C0SM1N23/siemens/cpu/README.md

# RISC-V RV32I CPU — 3-stage pipeline with AXI4-Lite

The CPU block of the SoC (CPU + DMA + DP-SRAM), in Verilog. A 3-stage RV32I
pipeline with two AXI4-Lite master ports, a branch predictor with a
return-address stack, precise traps, WFI, and an M-mode CSR file with
performance counters. The block includes the programmable interrupt controller
from the PIC brief ([pic.v](hdl/pic.v)) and a machine timer
([mtimer.v](hdl/mtimer.v)) for scheduling and timeout handling.

Block diagrams and per-module detail: [ARCHITECTURE.md](ARCHITECTURE.md). Test
plan and results: [debug/VERIFICATION.md](debug/VERIFICATION.md).

## Architecture

```
S1 FETCH ──────────── S2 DECODE + EXECUTE ─────────── S3 WRITEBACK
ibus_axi (AR/R)       decode, regfile, ALU, branch,    rd write
+ branch predictor    CSR, load/store on dbus_axi      (S3->S2 forwarding)
  (BTB/BHT, 128,      traps/interrupts resolve here;
   + 8-entry RAS)     WFI sleeps here (ibus goes idle)
```

One clock, async active-low reset. Pipeline registers carry a `valid` bit, so a
flushed or reset stage is a guaranteed no-op. Load-use hazards go through S3→S2
forwarding (no stall); the two AXI ports are independent, one outstanding
transaction each, so a fetch and a load/store overlap.

## Spec requirements vs. design decisions

The brief separates two kinds of item, so does this repo:

- **Spec requirements** (`REQ#`) — the original scope, interpreted using the
  RISC-V and AXI rules where the brief does not define detailed behaviour.
- **Design decisions** (`D#`) — points the brief left "for the intern to
  define". Each a deliberate choice with a rationale.

The tables below index the original requirements and project decisions.
Current interface details and limitations are in [docs/](docs/).

### Requirement mapping

| Tag | Requirement | File(s) |
|-----|---|---|
| REQ1  | 3-stage pipeline: Fetch / Decode+Execute / Writeback | [rv32i_cpu_top.v](hdl/rv32i_cpu_top.v) |
| REQ2  | Two AXI4-Lite master ports: ibus (read-only), dbus (read+write) | [rv32i_cpu_top.v](hdl/rv32i_cpu_top.v) |
| REQ3  | Top interface: 1 sync clock, async active-low reset, PIC lines | [rv32i_cpu_top.v](hdl/rv32i_cpu_top.v) |
| REQ4  | Interrupts sampled under `mstatus.MIE` at instruction boundaries; ack 1-cycle pulse; `cpu_in_trap` entry→MRET | [rv32i_cpu_top.v](hdl/rv32i_cpu_top.v) |
| REQ5  | Pipeline stalls until AXI response valid; data op stalls the whole round-trip | [rv32i_fetch_unit.v](hdl/rv32i_fetch_unit.v), [rv32i_lsu.v](hdl/rv32i_lsu.v) |
| REQ6  | Dedicated centralized hazard/stall/flush unit | [rv32i_hazard_unit.v](hdl/rv32i_hazard_unit.v) |
| REQ7  | RV32I instruction set; FENCE = NOP; ECALL/EBREAK trap-handled | [rv32i_control.v](hdl/rv32i_control.v) (+ reused alu/rv32i_decode/imm_gen) |
| REQ8  | 1-bit saturating branch predictor | [rv32i_branch_predictor.v](hdl/rv32i_branch_predictor.v) |
| REQ9  | The 7 required M-mode CSRs at their addresses; `mip` read-only, PIC-driven | [rv32i_csr_file.v](hdl/rv32i_csr_file.v) |
| REQ10 | Register file: 32×32, x0=0, 1 write / 2 combinational reads, reset 0 | [rv32i_regfile.v](hdl/rv32i_regfile.v) |
| REQ11 | WSTRB byte-lane writes (SB/SH/SW) as AXI / DP-SRAM require | [rv32i_lsu.v](hdl/rv32i_lsu.v) |
| REQ12 | Handle all AXI response codes (OKAY/SLVERR/DECERR) on both ports | [rv32i_fetch_unit.v](hdl/rv32i_fetch_unit.v), [rv32i_lsu.v](hdl/rv32i_lsu.v) |

### Design decisions (intern-defined)

| Tag | Decision | File(s) |
|-----|---|---|
| D1  | `valid`-bit pipeline registers → guaranteed safe bubble (not the NOP encoding) | [rv32i_cpu_top.v](hdl/rv32i_cpu_top.v) |
| D2  | S2 priority: interrupt > sync exception > mispredict, as a sequential check | [rv32i_cpu_top.v](hdl/rv32i_cpu_top.v) |
| D3  | Supported mcause set 0,1,2,3,4,5,6,7,11 + external interrupts on 16 PIC sources (causes 16..31) | [rv32i_exception_unit.v](hdl/rv32i_exception_unit.v), [rv32i_csr_file.v](hdl/rv32i_csr_file.v) |
| D4  | Trap return: exceptions → offending PC, interrupts → resume PC | [rv32i_cpu_top.v](hdl/rv32i_cpu_top.v) |
| D5  | `RESET_PC` + `HART_ID` params → `mhartid` (multi-core; beyond spec) | [rv32i_cpu_top.v](hdl/rv32i_cpu_top.v), [rv32i_csr_file.v](hdl/rv32i_csr_file.v) |
| D6  | ibus master fully independent, ≤1 outstanding, back-to-back fetch (1 instr/cycle) | [rv32i_fetch_unit.v](hdl/rv32i_fetch_unit.v) |
| D7  | Holding register keeps PC correct in a stall; in-flight fetch discarded on redirect | [rv32i_fetch_unit.v](hdl/rv32i_fetch_unit.v) |
| D8  | Fetch bus error → instruction access fault (mcause 1), not "illegal" | [rv32i_fetch_unit.v](hdl/rv32i_fetch_unit.v) |
| D9  | Predictor structure: BHT+BTB, direct-mapped, 128 entries, index PC[8:2], tag + stored target | [rv32i_branch_predictor.v](hdl/rv32i_branch_predictor.v) |
| D10 | Miss predicts not-taken | [rv32i_branch_predictor.v](hdl/rv32i_branch_predictor.v) |
| D11 | Learned at S2 resolution (non-speculative); entries kept across traps | [rv32i_branch_predictor.v](hdl/rv32i_branch_predictor.v) |
| D12 | ≤1 outstanding transaction; address/data latched at start | [rv32i_lsu.v](hdl/rv32i_lsu.v) |
| D13 | Load-use solved by S3→S2 forwarding, zero stall cycles | [rv32i_hazard_unit.v](hdl/rv32i_hazard_unit.v) |
| D14 | Flush beats stall; both priority rules gated by `s2_advance` | [rv32i_hazard_unit.v](hdl/rv32i_hazard_unit.v) |
| D15 | Unimplemented / read-only CSR access → illegal instruction (not DECERR) | [rv32i_csr_file.v](hdl/rv32i_csr_file.v) |
| D16 | Vectored mtvec: interrupts → BASE+4·cause, exceptions → BASE | [rv32i_csr_file.v](hdl/rv32i_csr_file.v) |
| D17 | Misalignment checked pre-access → no AXI transaction issued | [rv32i_exception_unit.v](hdl/rv32i_exception_unit.v) |
| D18 | Bus error → access fault (load 5 / store 7) | [rv32i_exception_unit.v](hdl/rv32i_exception_unit.v) |
| D19 | PIC implements the "Advanced Scheduling" brief: 16 hardware + 16 software sources → one prioritised `cpu_irq`/`cpu_irq_vec`, registered off the source timing path (D-LAT) | [pic.v](hdl/pic.v) |
| D20 | Custom priority grouping: 4 bands (per-band urgency in `BAND_CONFIG`) + per-source intra-band priority + lowest-index tie-break; deadline-aware escalation bumps a starved source's effective band (D-BAND / D-DDL) | [pic.v](hdl/pic.v) |
| D21 | Preemption with a nesting stack (depth ≤ `NEST_MAX`): `cpu_irq_ack` claims/pushes, `cpu_irq_eoi` returns/pops; a source that deasserts before its claim is flagged spurious + logged, never corrupts the stack (D-NEST / D-SPUR) | [pic.v](hdl/pic.v) |
| D22 | Full register map (SRCx_CONFIG/SW_TRIG/STATUS, BAND_CONFIG, NEST_STATUS/MAX, ACTIVE_VEC, SPURIOUS_LOG, ESCALATION_CFG, INT_ENABLE/STATUS); keyed software triggers; unmapped or read-only-write access answers SLVERR (D-SW / D-AXI) | [pic.v](hdl/pic.v) |
| D23 | WFI (Priv. spec 3.3.3): S2 sleeps, S1 parks → zero ibus traffic; wake on any mie-enabled pending irq, `mstatus.MIE` decides trap-vs-fall-through; interrupt wake sets mepc = wfi+4 | [rv32i_control.v](hdl/rv32i_control.v), [rv32i_cpu_top.v](hdl/rv32i_cpu_top.v), [rv32i_hazard_unit.v](hdl/rv32i_hazard_unit.v) |
| D24 | Return-address stack (8 entries, parameterized, 0 = off): calls/returns keyed on the ISA JALR hint regs (x1/x5); BTB entries tagged `is_ret` predict the RAS top; learned at commit like the BTB (never speculative) | [rv32i_branch_predictor.v](hdl/rv32i_branch_predictor.v) |
| D25 | `mhpmcounter3..7`: mispredicts, fetch-starved cycles, dbus stall cycles, traps taken, WFI sleep cycles — the CPU-side numbers that pair with DP-SRAM BANDWIDTH_A/B and DMA throttling. All counters are 64-bit with an upper half at base+0x80 and writable from M-mode (Priv. 3.1.11); the counters not provided are hardwired zero, not unimplemented | [rv32i_csr_file.v](hdl/rv32i_csr_file.v) |
| D26 | Machine timer (unassigned in the briefs): 64-bit mtime/mtimecmp, level irq = compare, born disarmed; handler clears by moving mtimecmp — feeds PIC source 7 | [mtimer.v](hdl/mtimer.v) |
| D27 | mtimer AXI4-Lite slave port, same discipline as the PIC's (D-AXI): 4 R/W word registers, SLVERR elsewhere, WSTRB honored per lane | [mtimer.v](hdl/mtimer.v) |

## AXI4-Lite interface (SoC integration)

Both ports are conformant AXI4-Lite masters — no proprietary extensions — so the
DMA config port and DP-SRAM Port A see a standard master.

- `ibus_axi` — read only (AR/R), instruction fetch.
- `dbus_axi` — read + write (AW/W/B/AR/R), load/store, `WSTRB` per byte lane (REQ11).
- One outstanding transaction per port; the FSMs split per channel, so a later
  move to AXI4-Full (bursts, IDs) stays additive, not a rewrite (D6, D12).
- All three response codes handled (REQ12): OKAY, plus SLVERR/DECERR → precise
  access-fault traps (D8, D18). DP-SRAM only emits OKAY/SLVERR; DECERR comes
  from the interconnect on an unmapped address — the CPU covers both.

## Interrupts (PIC)

The PIC implements the *Programmable Interrupt Controller with Advanced
Scheduling* brief ([pic/](pic/)): 16 hardware sources + 16 software channels
(32 logical sources), custom priority grouping, preemption with nesting,
spurious detection, deadline-aware escalation, and software-triggered
interrupts. Full design in [pic.v](hdl/pic.v) and [ARCHITECTURE.md](ARCHITECTURE.md) §5.

The CPU side: `cpu_irq_i` (single level request), `cpu_irq_vec_i[3:0]` (id of
the offered source), `cpu_irq_ack_o` (1-cycle claim pulse at handler entry),
`cpu_irq_eoi_o` (1-cycle pulse on an interrupt-returning MRET). Every port in
the design carries a direction suffix, `_i` or `_o`; internal wires do not. A source maps
to mcause `16+vec`; the CPU builds a one-hot `mip[16+vec]` from the offer, and
`mie[16+vec]` is the per-source CPU enable. An irq is taken only at an
instruction boundary, only under `mstatus.MIE`, held through a multi-cycle AXI
stall (REQ4; priority D2).

The PIC side (D19–D22): a slot's request is `(level ? irq_src : edge_latch |
sw) & INT_ENABLE`. The resolver builds an effective priority key
`{band_urgency, intra_priority, ~index}` per source and offers the most urgent
one that is strictly above the top of the nesting stack, so a higher source
**preempts** a lower one; `cpu_irq_ack` pushes it (claim), `cpu_irq_eoi` pops it
(return). A source whose deadline elapses before it is serviced has its band
**escalated** (`ESCALATION_CFG`). A source that deasserts before its claim is
flagged **spurious** (`SPURIOUS_LOG`, `INT_STATUS.SPUR`) without corrupting the
stack. Software injects an interrupt with a keyed `SRCx_SW_TRIG` write. Everything
is programmed over an AXI4-Lite slave port (register map in ARCHITECTURE.md §5);
unmapped words and read-only writes answer SLVERR. The PIC's `INT_ENABLE` and the
CPU's `mie` are two independent masks: a source PIC-enabled but `mie`-masked sits
as the PIC's offer forever and starves the rest, so route a source into the PIC
only if some handler will service it.

The timer ([mtimer.v](hdl/mtimer.v), D26/D27) sits on PIC source 7:
64-bit `mtime`/`mtimecmp` behind an AXI4-Lite slave port, level irq while
`mtime >= mtimecmp`, disarmed at reset. With WFI (D23) it gives the SoC an
idle mode: program the DMA, arm the timer as a deadline, execute WFI. The CPU
stops fetching while the DMA works; either the completion interrupt or the
timer wakes it. A timeout handler can abort a stuck DMA channel over
`CHx_CONTROL`.

## Multi-core

Nothing shared between instances: no static state, memories external, identity
only from the `HART_ID`/`RESET_PC` parameters (D5). Two or more cores work
behind a standard AXI interconnect. RV32I has no LR/SC, but each core is
in-order with blocking memory ops (sequentially consistent per hart), so
flag-based sharing through memory is sound — the same property the SoC's
ping-pong buffering relies on. `debug/hdl/rv32i_tb_dual_core.v` shows two cores
sharing one memory through an arbiter.

## Layout

```
hdl/
  rv32i_cpu_top.v            top level: pipeline + AXI + PIC          (REQ1-4; D1,D2,D4,D5)
  rv32i_fetch_unit.v         S1: PC + ibus master + holding/redirect  (REQ5,12; D6-D8)
  rv32i_branch_predictor.v   BTB/BHT                                  (REQ8; D9-D11)
  rv32i_lsu.v                S2: dbus master, alignment + WSTRB       (REQ5,11,12; D12)
  rv32i_hazard_unit.v        centralized stall/flush/forwarding       (REQ6; D13,D14)
  rv32i_control.v            decoder (RV32I, FENCE=NOP, SYSTEM)       (REQ7)
  rv32i_csr_file.v           M-mode CSRs + trap/MRET sequencing       (REQ9; D3,D5,D15,D16)
  rv32i_exception_unit.v     sync exception detect                    (D3,D17,D18)
  pic.v                advanced-scheduling interrupt controller (D19-D22)
  mtimer.v             machine timer, AXI4-Lite + irq to PIC 7  (D26,D27)
  axi_lite_slave.v     reusable AXI4-Lite register interface (shared by pic/mtimer)
  rv32i_regfile.v            32x32 register file                      (REQ10)
  rv32i_branch_unit.v        real branch/jump direction + target
  rv32i_decode.v  rv32i_imm_gen.v  rv32i_alu.v  rv32i_alu_top.v  rv32i_writeback_mux.v   (reused, combinational)
debug/
  VERIFICATION.md      test plan: what is checked, why, and known gaps
debug/formal/
  pic_formal.sv  pic.sby  SymbiYosys harness: stack, limit, key and offer invariants
  run_formal.sh        proofs, then the harness against injected defects
debug/sva/
  axi_lite_sva.sv      AXI4-Lite contract as SVA (per port: ibus/dbus/PIC)
  rv32i_cpu_core_sva.sv      pipeline invariants as SVA (REQ4,10,11; D2,D3,D12)
  pic_sva.sv           PIC invariants as SVA (D-LAT/D-BAND/D-NEST)
  rv32i_cpu_func_cov.sv      functional coverage bins + end-of-run [FCOV] table
  rv32i_bind_sva.sv          attaches everything with bind - zero RTL edits
debug/hdl/
  rv32i_tb_cpu_axi.v         self-checking TB: CPU + real PIC @ 0x3000_0000 + AXI
                       memories + monitors; the TB plays the peripherals
  pic_tb_feature.v             standalone PIC feature bench: bands, nesting, spurious,
                       deadline escalation, software triggers, AXI responses
  rv32i_tb_dual_core.v       2 CPUs + shared memory behind an arbiter (scalability proof)
  axi_lite_monitor.v   passive AXI4-Lite protocol checker (ibus, dbus, PIC port)
  axi_lite_mem_model.v behavioral AXI4-Lite slave (OKAY/DECERR, latency + seeded
                       random READY backpressure)
  axi_lite_arb2.v      2:1 AXI4-Lite arbiter (TB stand-in for the interconnect)
  axi_lite_dec2.v      1-master/2-slave address decoder (TB interconnect for
                       the PIC window)
  ck_rst_tb.v          clock/reset generator (async reset, released at 123 ns)
  pic_tb_reset.v       PIC reset values, X-freedom, asynchronous reset
  pic_tb_ro.v          PIC read-only registers and reserved bits
  pic_tb_status.v      PIC SRCx_STATUS, field by field
  mtimer_tb_regs.v     machine-timer registers, reset and access rules
  rv32i_tb_csr_ro.v          CSR file: read-only, WARL, tied-off, absent
  rv32i_tb_traps.v           one directed test per trap cause, at CPU level
  rv32i_tb_bp.v              branch predictor: tables, RAS boundaries, reset
  rv32i_tb_alu.v             ALU operation decode and operand boundaries
  pic_tb_random.v      constrained-random PIC traffic, traced for pic_model.py
  rv32i_tb_riscv_tests.v     runs one official riscv-test, verdict from tohost
  tb_check.vh          shared self-check task (=== compare, PASS/FAIL per check)
  tb_axil_master.vh    shared AXI4-Lite master driver tasks for the block benches
  axi_lite_macros.vh   bare AXI read/write helper macros shared by the benches
debug/sim/
  program_axi.s        main test program   (py asm.py program_axi.s program_axi.hex)
  program_dual.s       dual-core handshake (py asm.py program_dual.s program_dual.hex)
  asm.py               tiny RV32I assembler (range-checked imms, %hi/%lo, .org)
  rtl.f  tb_cpu.f      shared filelists — one module list for both flows,
                       ordered bottom-up by dependency level (see rtl.f header)
  tb_block.f           filelist for the block-level benches
  compile.do           the single canonical vlog compile both .do scripts use
  rv32i_soc_map.vh           TB address map (PIC / mtimer / dmem bases) in one place
  sim.do               quick single run     regress.do  full 39-run regression
  wave.do              AXI-grouped waveform set for the ModelSim GUI
  run_verilator.sh     SVA + functional coverage run (Verilator, free)
  isa_reference.py     ISA encoder/interpreter: directed and ten random programs
  pic_model.py         cycle-accurate PIC model, replays pic_tb_random traces
  merge_fcov.py        functional coverage merged over runs, with its gate
  check_covers.py      cover properties merged over runs, with its gate
  run_riscv_tests.sh   official rv32ui/rv32mi tests (riscv_tests.ld, riscv_tests_expected.json)
  mutation_check.py    injects RTL defects one at a time; each must fail its bench
  run_verilator.ps1    same, one command from Windows (via WSL)
  verif_gui.py         tkinter front-end that launches the flows and shows
                       PASS/FAIL per job (no ModelSim/Verilator CLI needed)
```

## Simulation

From `cpu/debug/sim`:

```text
python isa_reference.py
python pic_reference.py
python asm.py program_axi.s program_axi.hex
python asm.py program_dual.s program_dual.hex
vsim -c -do "do regress.do; quit -f"
```

Verilator, from the repository root in Bash/WSL:

```text
bash cpu/debug/sim/run_verilator.sh
```

Windows launcher: `cpu/debug/sim/run_verilator.ps1`. GUI:
`python cpu/debug/sim/verif_gui.py`.

The ModelSim regression has 17 benches and 39 runs, timing variants and random
seeds included. Verilator runs all of them with the bound SVA, merges the
functional coverage over the runs and requires every cover property to be
reached. The official riscv-tests, the PIC's formal proofs and the mutation
check complete the evidence. ModelSim compilation reports zero errors/warnings;
CPU RTL lint is clean under the recorded options. RTL files have no
`timescale`; verification supplies simulation time units.

Test inventory, commands and limits: [debug/VERIFICATION.md](debug/VERIFICATION.md).

## Integration contract

The SoC memory and interrupt maps are defined in
[../soc/README.md](../soc/README.md). The sixteen-source claim/EOI interface is
a project decision that resolves differing CPU/PIC brief widths; it is recorded
in [../INTEGRATION.md](../INTEGRATION.md).

The current PIC targets one CPU. The dual-core bench verifies two CPU instances
sharing data memory; it does not implement multicore interrupt routing.
The core's trap-kind stack supports sixteen combined open interrupt/exception
levels. Software must stay within that limit.
