C0SM1N23/siemens/docs/README.md

# docs

Shared project material and the faculty internship report. The RTL and its testbenches
stay in [cpu/](../cpu/), [dma/](../dma/), [sram/](../sram/) and [soc/](../soc/).

The Design and Verification Specifications live with the blocks they describe,
in [cpu/docs/](../cpu/docs/), not here.

| Path | What it is |
|---|---|
| [practica/](practica/) | Internship report for the faculty — LaTeX source and the built PDF. The completed logbook (DOCX) is kept locally. |
| `brief/` | Shared/DMA/SRAM Siemens material, kept locally. CPU/PIC briefs are in `cpu/docs/brief/`. |
| `../cpu/docs/tehnic/`, `../cpu/docs/diagrame/`, `../cpu/docs/note/` | Local engineering notes, drawio drawings and the changelog. |

## practica/

`Raport_practica_Bunea_Cosmin-Andrei.tex` is a single self-contained file: no
`\input`, no separate preamble. The only external file it needs is the
university logo in `assets/`.

**It must be built with LuaLaTeX, not pdfLaTeX.** Romanian `ș` and `ț` carry a
comma below, not a cedilla, and only the OpenType font has real glyphs for them;
under pdfLaTeX with T1 they get composed from a base letter plus an accent and
look wrong.

```
cd docs/practica
lualatex Raport_practica_Bunea_Cosmin-Andrei.tex   # three times, for the ToC
```

42 pages. Covers the internship context and the split of work between the three
interns, the RV32I CPU, the interrupt controller and the machine timer, the SoC
integration, and the verification results.

The faculty report is retained as submitted. Current CPU/SoC technical results
are maintained in the block specifications and verification documents.

## A note on what is committed

`.gitignore` keeps PDFs, Office documents and archives out of the repository,
because `brief/` holds Siemens material marked Restricted. The faculty report
and the authored CPU/PIC specifications, figures and presentations are explicit
exceptions, committed with their sources.
