C0SM1N23/siemens/cpu/docs/figures/pic_essential.pdf

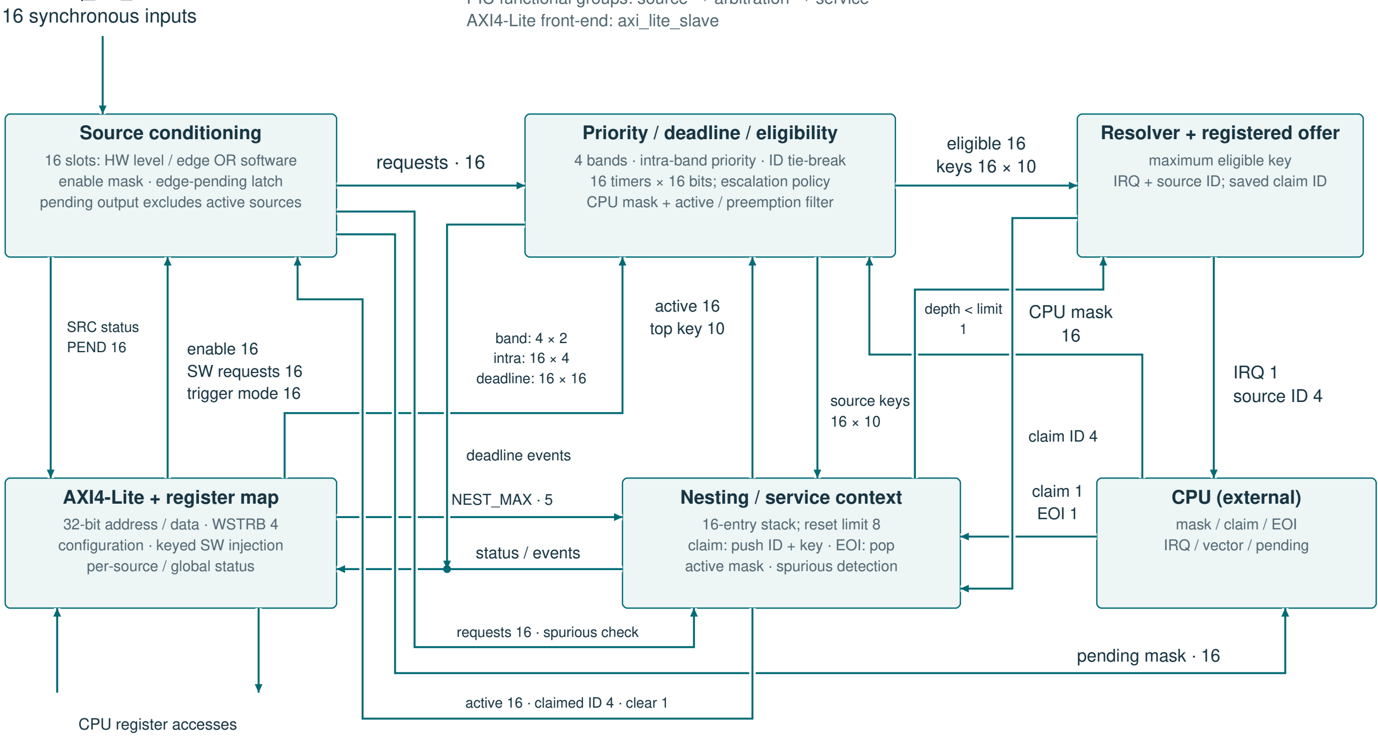
[picture p6: figure]
Source conditioning 16 slots: HW level / edge OR software enable mask · edge-pending latch pending output excludes active sources; Priority / deadline / eligibility; 16 timers × 16 bits; escalation policy CPU mask + active / preemption filter; Resolver + registered offer maximum eligible key IRQ + source ID; saved claim ID; AXI4-Lite + register map 32-bit address / data · WSTRB 4 configuration · keyed SW injection per-source / global status; Nesting / service context 16-entry stack; reset limit 8 claim: push ID + key · EOI: pop active mask · spurious detection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

4 bands · intra-band priority · ID tie-break

## irq_src_i

PIC functional groups: source → arbitration → service

AW / W / AR requests; B / R responses Priority key: urgency 2 + intra-band priority 4 + inverted ID 4.
