C0SM1N23/siemens/cpu/docs/figures/cpu_software.pdf

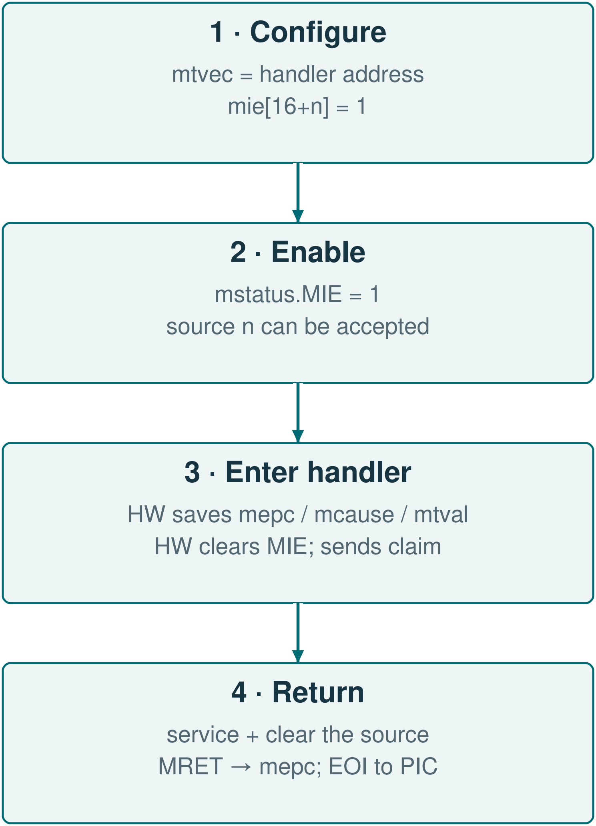
[picture p41: figure]
1 · Configure mtvec = handler address mie[16+n] = 1; 2 · Enable mstatus.MIE = 1 source n can be accepted; 3 · Enter handler HW saves mepc / mcause / mtval HW clears MIE; sends claim; 4 · Return service + clear the source MRET → mepc; EOI to PIC

CPU instructions ↔ hardware state
