C0SM1N23/siemens/cpu/docs/figures/pic_software.pdf

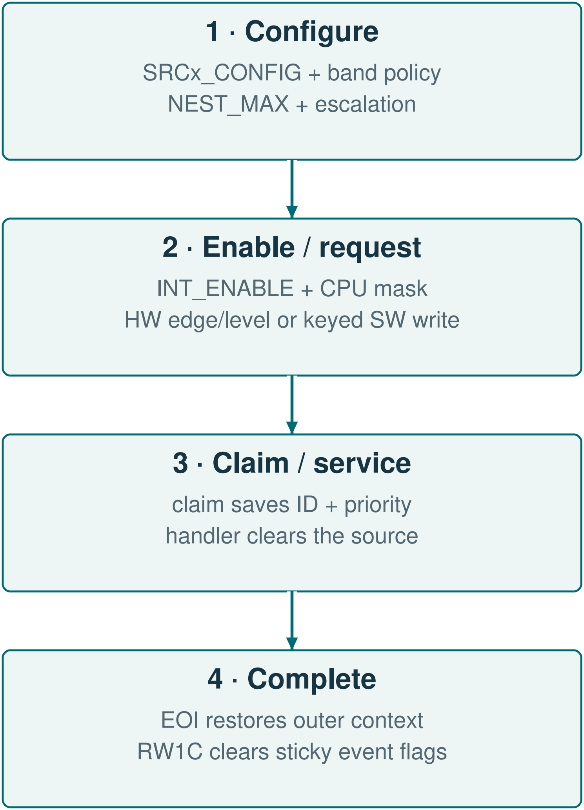
[picture p42: figure]
1 · Configure SRCx_CONFIG + band policy NEST_MAX + escalation; 2 · Enable / request INT_ENABLE + CPU mask HW edge/level or keyed SW write; 3 · Claim / service claim saves ID + priority handler clears the source; 4 · Complete EOI restores outer context RW1C clears sticky event flags

Register configuration → service sequence
