C0SM1N23/siemens/cpu/docs/waves/cpu_fetch.png

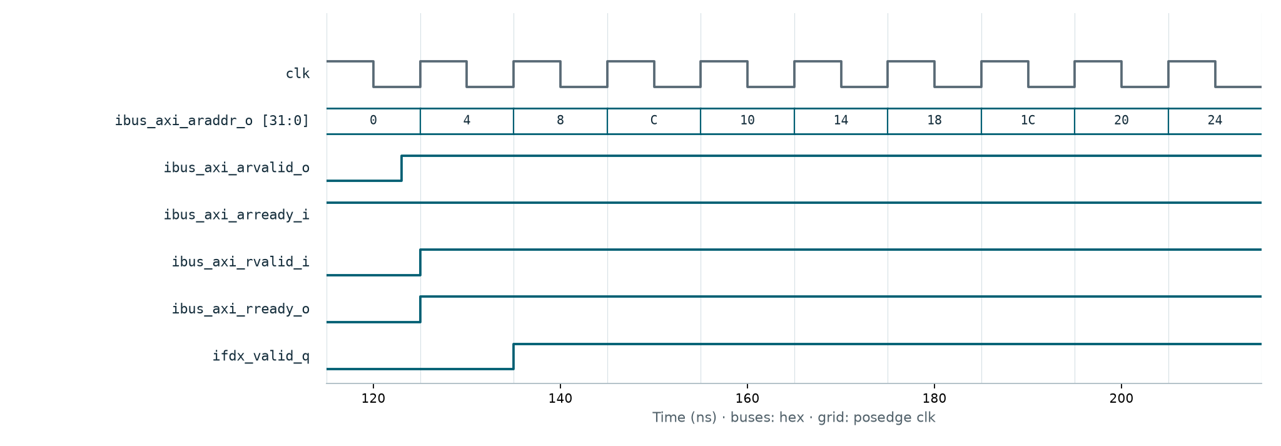
cpu/docs/waves/cpu_fetch.png
