C0SM1N23/siemens/cpu/docs/waves/cpu_load.png

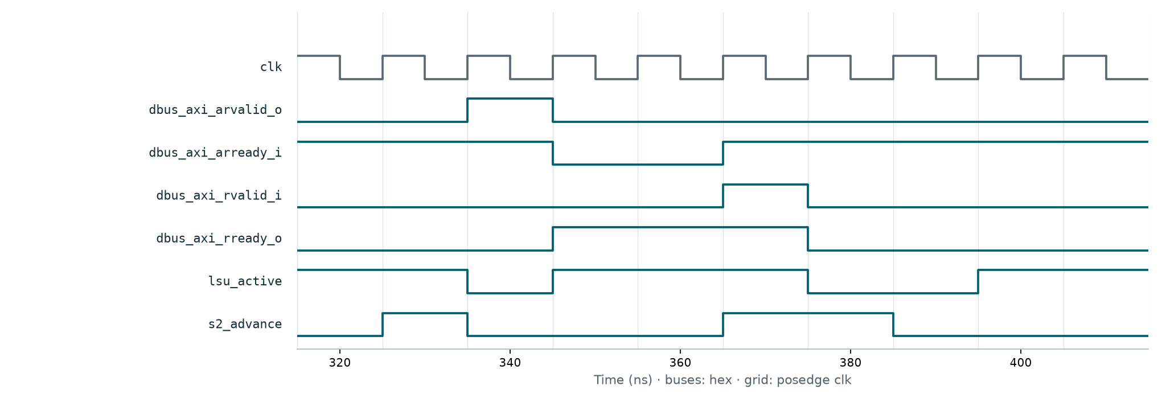
cpu/docs/waves/cpu_load.png
