C0SM1N23/siemens/cpu/docs/waves/cpu_redirect.png

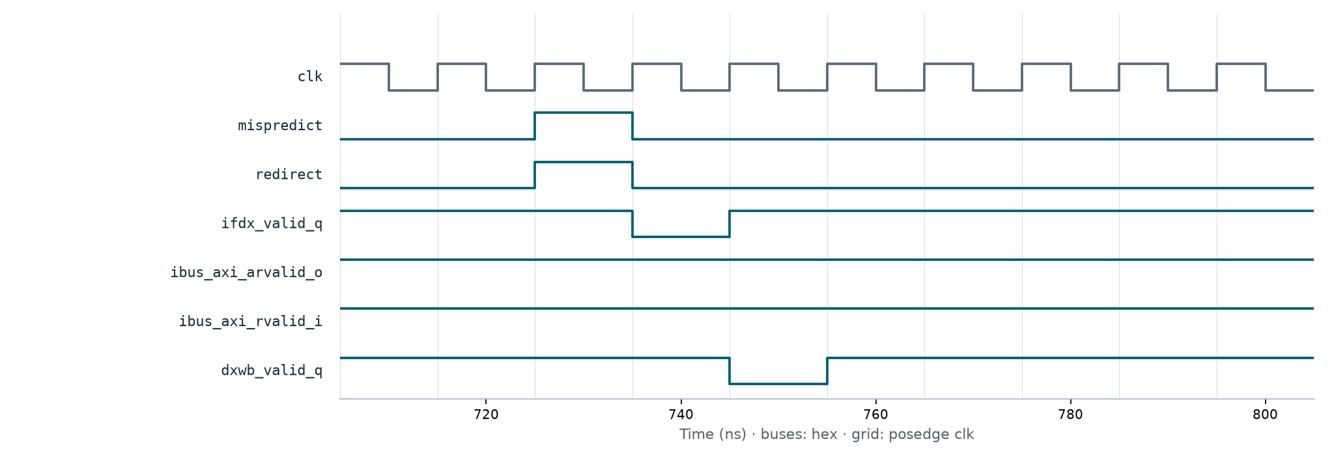
cpu/docs/waves/cpu_redirect.png
