C0SM1N23/siemens/cpu/docs/waves/cpu_reset.png

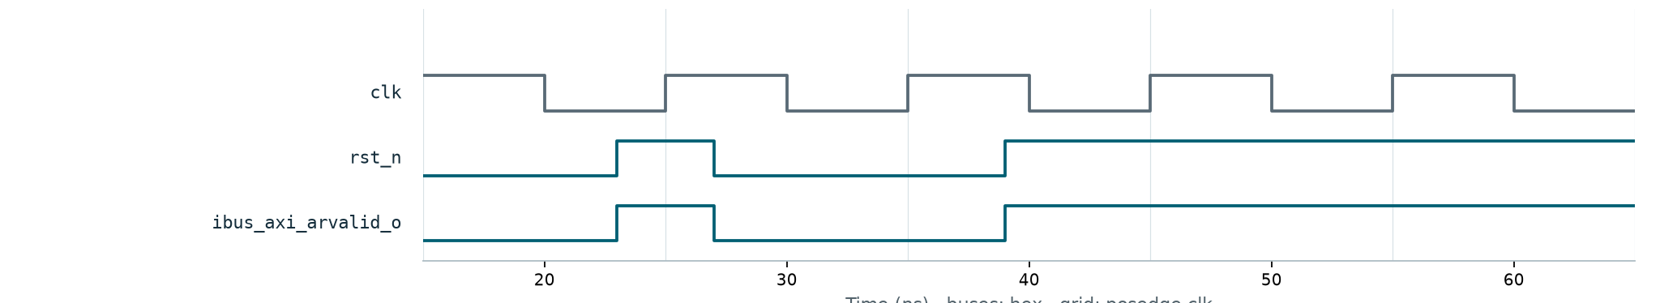
cpu/docs/waves/cpu_reset.png
