C0SM1N23/siemens/cpu/docs/waves/cpu_reset_stopped.png

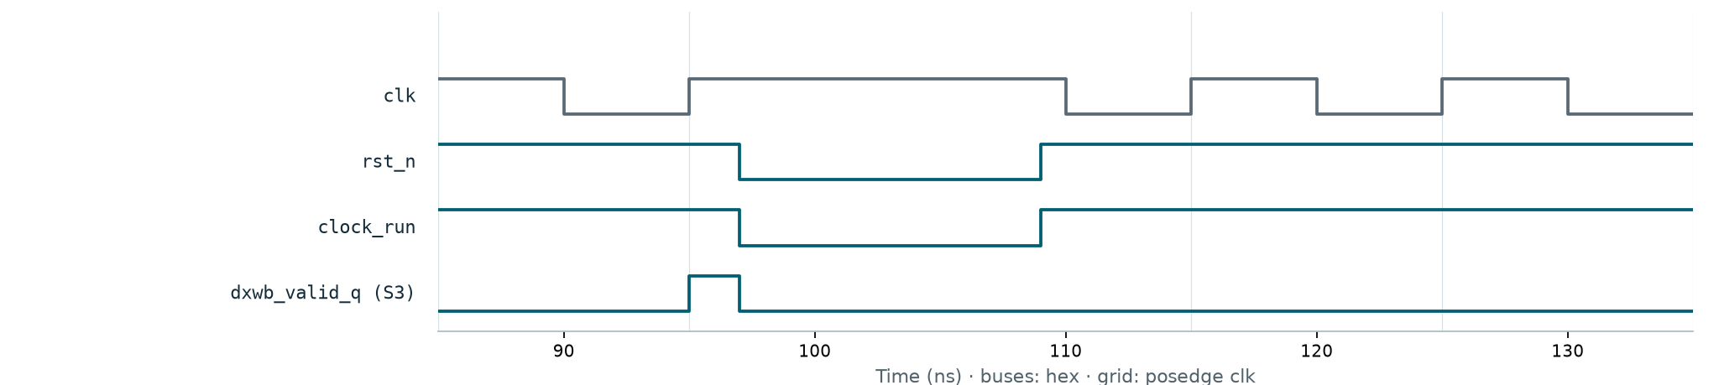
cpu/docs/waves/cpu_reset_stopped.png
