C0SM1N23/siemens/cpu/docs/waves/cpu_store.png

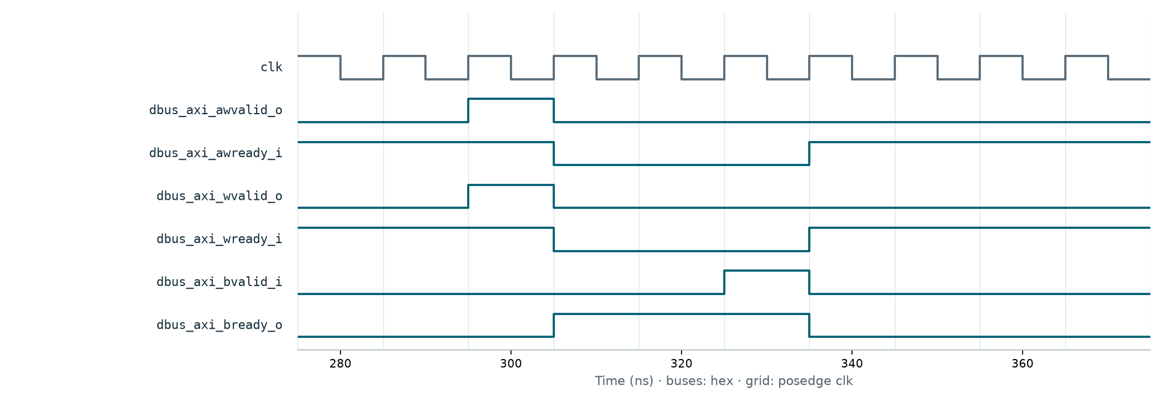
cpu/docs/waves/cpu_store.png
