C0SM1N23/siemens/cpu/docs/waves/pic_claim.png

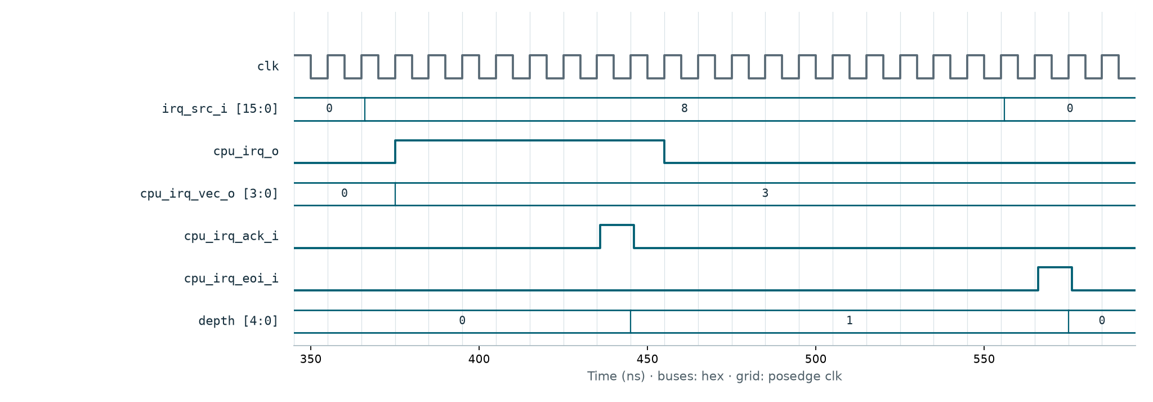
cpu/docs/waves/pic_claim.png
