C0SM1N23/siemens/cpu/docs/waves/pic_edge_claim.png

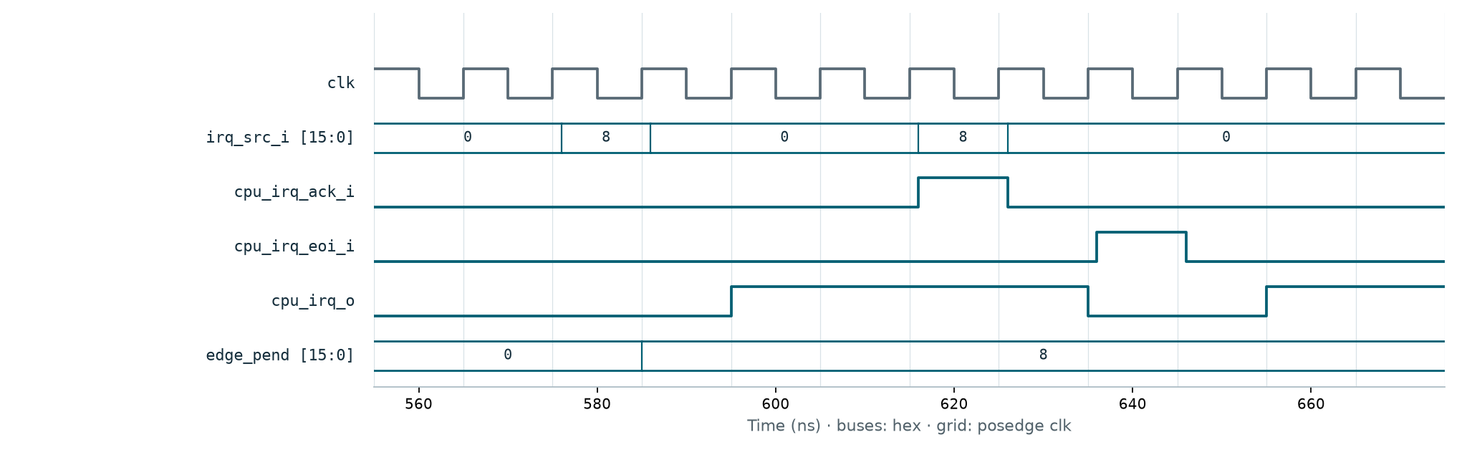
cpu/docs/waves/pic_edge_claim.png
