C0SM1N23/siemens/cpu/docs/waves/pic_escalation.png

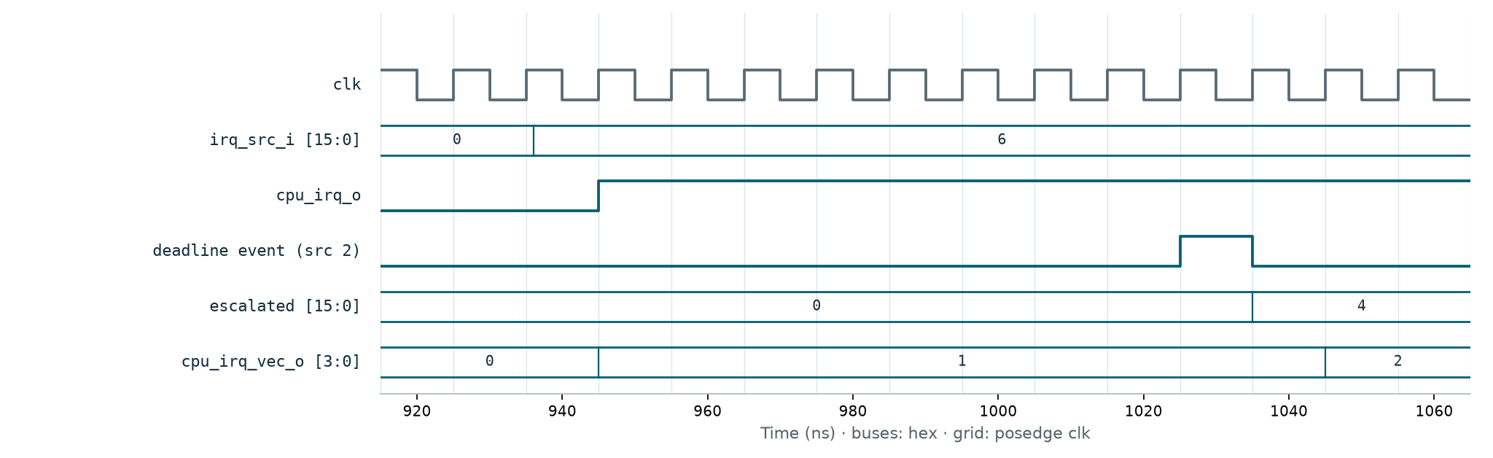
cpu/docs/waves/pic_escalation.png
