C0SM1N23/siemens/cpu/docs/waves/pic_reset.png

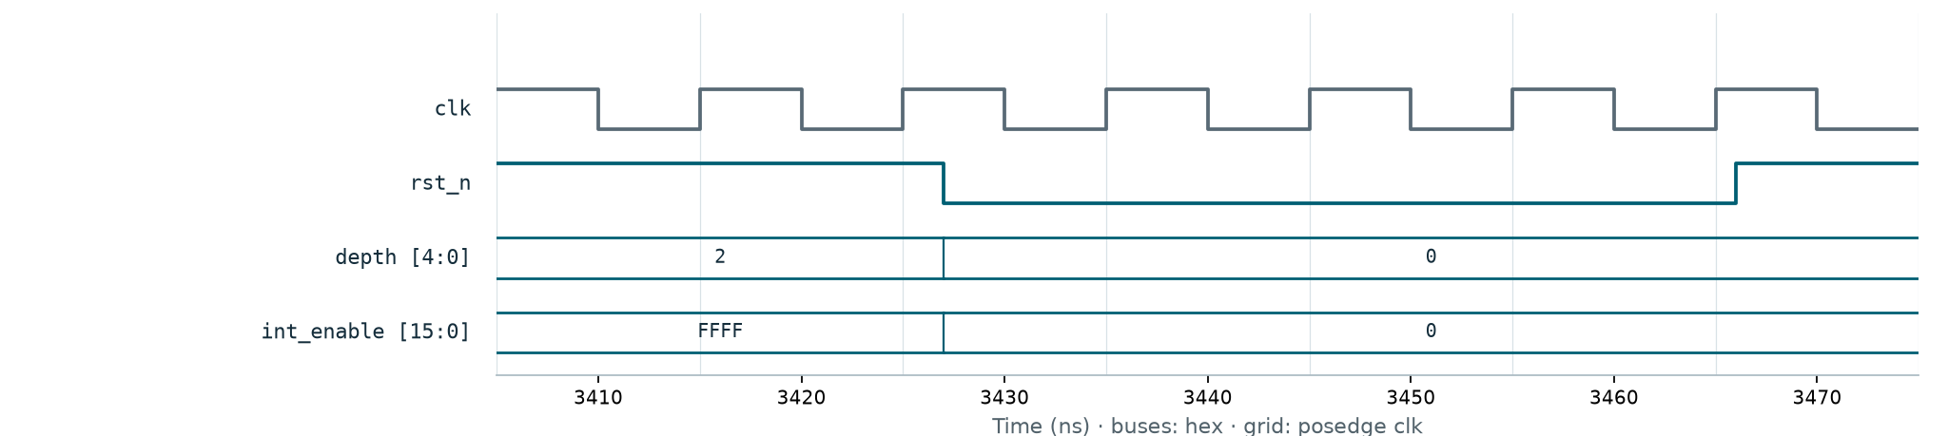
cpu/docs/waves/pic_reset.png
