C0SM1N23/siemens/cpu/docs/waves/pic_spurious.png

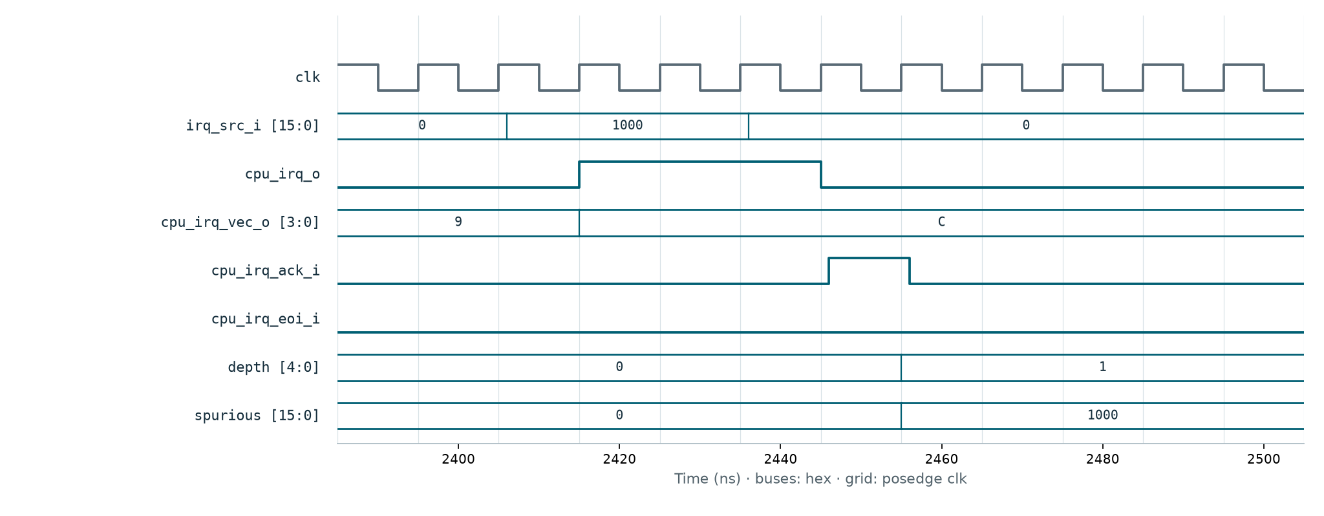
cpu/docs/waves/pic_spurious.png
