C0SM1N23/siemens/sram/debug/sim/dp_sram_top_stress_test_vectors.txt

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

REM ==================== Section 1: AXI4-Lite Write Channel Timing ====================

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

REM ---- Test 1.3: back-to-back writes with zero idle cycles -- RELAXED ----
REM The main loop inserts one @(posedge clk) between every instruction, so two
REM WRITE lines in a row cannot exercise the true zero-gap case. Relaxed version
REM below (still useful: confirms no leftover aw_have/w_have state, just not
REM on the exact same clock edge as the previous transaction's completion).
RESET      -        -        -        -
WRITE      A        004      00000001 -
WRITE      A        008      00000001 -
READ       A        004      00000001 -
READ       A        008      00000001 -
WRITE      A        004      00000000 -
WRITE      A        008      00000000 -

REM ---- Test 1.4: read arriving while a write is half-assembled ----
REM Covered by the same STAGGERWRITE task above -- it already checks
REM ARREADY=0 on every cycle of the 5-cycle wait between AW and W.
REM (See tests 1.1/1.2 above; no separate vectors needed.)

REM ==================== Section 2: Delayed Response Handshake ====================

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

REM ==================== Section 3: Byte Strobe (WSTRB) Coverage ====================

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

REM ==================== Section 4: Collision Arbitration ====================

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

REM ==================== Section 5: dp_sram_regfile.v -- Additional Cases ====================

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

REM ---- Test 5.4: BANDWIDTH read exactly at window rollover -- SEE NOTE ----
REM Default WINDOW_CYCLES=1024 in dp_sram_regfile.v; dp_sram_top.v does not
REM expose WINDOW_CYCLES as a pass-through parameter, so it cannot be shortened
REM from this top-level testbench. Recommended: run this test against
REM dp_sram_regfile.v directly (tb_dp_sram_regfile.v), once its port list is
REM updated to the current _i/_o interface -- that testbench already supports a
REM shortened WINDOW_CYCLES override and a direct ACTIVITY command for a_mem_valid_i.

REM ---- Test 5.5: rapidly toggling activity within a window -- SEE NOTE ----
REM Same recommendation as 5.4: better suited to dp_sram_regfile.v unit-level testing.

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

REM ---- Test 5.7: BANDWIDTH activity-duration boundary/mid-range -- SEE NOTE ----
REM Same recommendation as 5.4/5.5.

REM ==================== Section 6: System-Level Integration ====================

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
