C0SM1N23/siemens/dma/debug/sim/test.txt

W 00000008 A5A5A5A5
D 00000014 00000000
R 00000008 00000000

W 00000018 A5A5A5A4
D 00000014 00000000
R 00000018 00000000

W 00000028 A5A5A5A3
D 00000014 00000000
R 00000028 00000000

W 00000038 A5A5A5A2
D 00000014 00000000
R 00000038 00000000
