C0SM1N23/siemens/dma/debug/sim/test_full.txt

W 00000008 FFFFFFFF
W 00000000 00000100
W 00000004 00000001
D 000005DC 00000000
R 0000000C 00000000
