C0SM1N23/siemens/cpu/docs/figures/cpu_verification.pdf

## One verdict: expected result + legal protocol + completed test

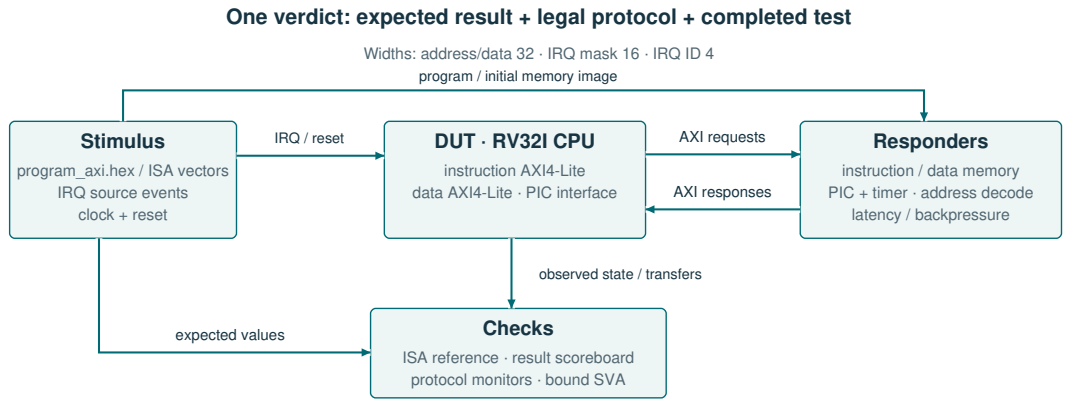
[picture p62: page 1]
IRQ / reset; AXI requests; AXI responses; expected values

Widths: address/data 32 · IRQ mask 16 · IRQ ID 4
program / initial memory image

Stimulus
program_axi.hex / ISA vectors
IRQ source events
clock + reset

DUT · RV32I CPU
instruction AXI4-Lite
data AXI4-Lite · PIC interface

Responders
instruction / data memory
PIC + timer · address decode
latency / backpressure

observed state / transfers
Checks

ISA reference · result scoreboard
protocol monitors · bound SVA
