C0SM1N23/siemens/cpu/docs/figures/cpu_essential.pdf

S1 · FETCH | S2 · DECODE + EXECUTE | S3 · WB

### Instruction memory

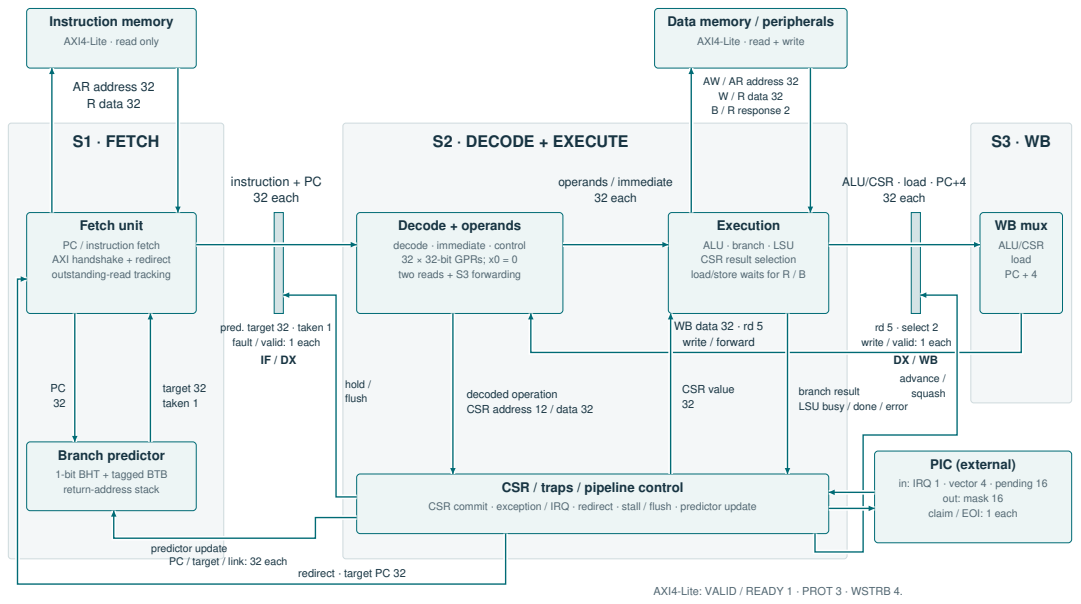
[picture p63: page 1]
WB mux ALU/CSR load PC + 4; AR address 32 R data 32; instruction + PC 32 each; operands / immediate 32 each; target 32 taken 1; CSR value 32; hold / flush; advance / squash

Data memory / peripherals
AXI4-Lite · read + write

AXI4-Lite · read only

AW / AR address 32
W / R data 32
B / R response 2

ALU/CSR · load · PC+4
32 each

Fetch unit
PC / instruction fetch
AXI handshake + redirect
outstanding-read tracking

Decode + operands
decode · immediate · control
32 × 32-bit GPRs; x0 = 0
two reads + S3 forwarding

Execution
ALU · branch · LSU
CSR result selection
load/store waits for R / B

pred. target 32 · taken 1
fault / valid: 1 each

WB data 32 · rd 5
write / forward

rd 5 · select 2
write / valid: 1 each

branch result
LSU busy / done / error

decoded operation
CSR address 12 / data 32

Branch predictor
1-bit BHT + tagged BTB
return-address stack

PIC (external)
in: IRQ 1 · vector 4 · pending 16

CSR / traps / pipeline control

out: mask 16
claim / EOI: 1 each

CSR commit · exception / IRQ · redirect · stall / flush · predictor update

predictor update
PC / target / link: 32 each

redirect · target PC 32

AXI4-Lite: VALID / READY 1 · PROT 3 · WSTRB 4.
