C0SM1N23/siemens/docs/practica/assets/Logo-UT-NEGRU-RO.pdf

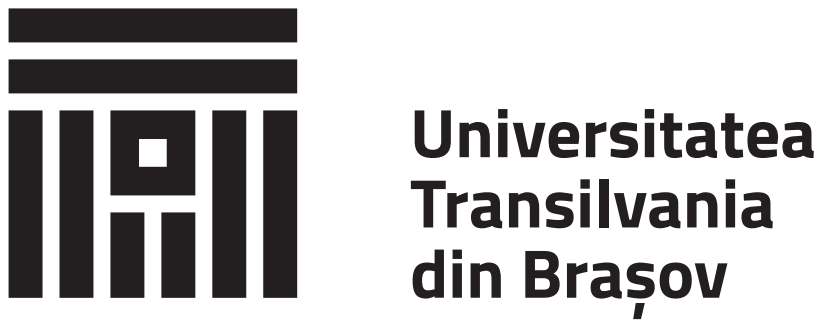
[picture p64: page 1]
