C0SM1N23/siemens/dma/hdl/mc_dma_priority_arbiter.v

module mc_dma_priority_arbiter (
    input               clk_i,
    input               rst_ni,

    // Global scheduling policy
    input       [31:0]  sched_policy_i, // 0 = Fixed Priority, 1 = Round Robin

    // Requests from the 4 Channels
    input       [3:0]  ch_req_i,
    
    input [3:0] [31:0] ch_req_addr_i,
    input [3:0] [7:0]  ch_req_len_i,
    input [3:0]        ch_req_is_write_i,

    // Grants sent back to the Channels
    output reg  [3:0]   ch_gnt_o,

    // Unified Request sent to the AXI-Full Master
    output reg          master_req_valid_o,
    output reg  [31:0]  master_req_addr_o,
    output reg  [7:0]   master_req_len_o,
    output reg          master_req_is_write_o,
    output reg  [1:0]   master_req_ch_id_o,
    input               master_req_ready_i
);

    reg  [1:0]  last_gnt;       
    reg  [3:0]  fixed_gnt;      
    reg  [3:0]  rr_gnt;         
    reg  [3:0]  selected_gnt;   

    // 1. Winner for Fixed Priority
    always @(*) begin
        fixed_gnt = 4'b0000;
        if (ch_req_i[0])
            fixed_gnt = 4'b0001;
        else if (ch_req_i[1])
            fixed_gnt = 4'b0010;
        else if (ch_req_i[2])
            fixed_gnt = 4'b0100;
        else if (ch_req_i[3])
            fixed_gnt = 4'b1000;
    end

    // 2. Winner for Round-Robin
    always @(*) begin
        rr_gnt = 4'b0000;
        if (last_gnt == 2'd0) begin
            if (ch_req_i[1])
                rr_gnt = 4'b0010;
            else if (ch_req_i[2])
                rr_gnt = 4'b0100;
            else if (ch_req_i[3])
                rr_gnt = 4'b1000;
            else if (ch_req_i[0])
                rr_gnt = 4'b0001;
        end else if (last_gnt == 2'd1) begin
            if (ch_req_i[2])
                rr_gnt = 4'b0100;
            else if (ch_req_i[3])
                rr_gnt = 4'b1000;
            else if (ch_req_i[0])
                rr_gnt = 4'b0001;
            else if (ch_req_i[1])
                rr_gnt = 4'b0010;
        end else if (last_gnt == 2'd2) begin
            if (ch_req_i[3])
                rr_gnt = 4'b1000;
            else if (ch_req_i[0])
                rr_gnt = 4'b0001;
            else if (ch_req_i[1])
                rr_gnt = 4'b0010;
            else if (ch_req_i[2])
                rr_gnt = 4'b0100;
        end else if (last_gnt == 2'd3) begin
            if (ch_req_i[0])
                rr_gnt = 4'b0001;
            else if (ch_req_i[1])
                rr_gnt = 4'b0010;
            else if (ch_req_i[2])
                rr_gnt = 4'b0100;
            else if (ch_req_i[3])
                rr_gnt = 4'b1000;
        end
    end

    // 3. Final winner based on global policy
    always @(*) begin
        if (sched_policy_i == 32'd0)
            selected_gnt = fixed_gnt;
        else
            selected_gnt = rr_gnt;
    end

    // 4. Update last_gnt when a request is accepted
    always @(posedge clk_i or negedge rst_ni) begin
        if (~rst_ni) begin
            last_gnt <= 2'd3;
        end else if (master_req_valid_o && master_req_ready_i) begin
            if (selected_gnt[0])
                last_gnt <= 2'd0;
            else if (selected_gnt[1])
                last_gnt <= 2'd1;
            else if (selected_gnt[2])
                last_gnt <= 2'd2;
            else if (selected_gnt[3])
                last_gnt <= 2'd3;
        end
    end

    // 5. Assert the grant signal to the winning channel
    always @(posedge clk_i or negedge rst_ni) begin
        if (~rst_ni)
            ch_gnt_o <= 4'b0000;
        else if (master_req_valid_o && master_req_ready_i)
            ch_gnt_o <= selected_gnt;
        else
            ch_gnt_o <= 4'b0000;
    end

    // 6. Send data to the Master based on the winner
    always @(*) begin
        if (selected_gnt != 4'b0000)
            master_req_valid_o = 1'b1;
        else
            master_req_valid_o = 1'b0;
    end

    always @(*) begin
        master_req_addr_o     = 32'h00000000;
        master_req_len_o      = 8'h00;
        master_req_is_write_o = 1'b0;
        master_req_ch_id_o    = 2'd0;

        if (selected_gnt[0]) begin
            master_req_addr_o     = ch_req_addr_i[0];
            master_req_len_o      = ch_req_len_i[0];
            master_req_is_write_o = ch_req_is_write_i[0];
            master_req_ch_id_o    = 2'd0;
        end
        else if (selected_gnt[1]) begin
            master_req_addr_o     = ch_req_addr_i[1];
            master_req_len_o      = ch_req_len_i[1];
            master_req_is_write_o = ch_req_is_write_i[1];
            master_req_ch_id_o    = 2'd1;
        end
        else if (selected_gnt[2]) begin
            master_req_addr_o     = ch_req_addr_i[2];
            master_req_len_o      = ch_req_len_i[2];
            master_req_is_write_o = ch_req_is_write_i[2];
            master_req_ch_id_o    = 2'd2;
        end
        else if (selected_gnt[3]) begin
            master_req_addr_o     = ch_req_addr_i[3];
            master_req_len_o      = ch_req_len_i[3];
            master_req_is_write_o = ch_req_is_write_i[3];
            master_req_ch_id_o    = 2'd3;
        end
    end
endmodule
