C0SM1N23/siemens/cpu/docs/tools/refined_diagrams.py

"""Functional hierarchy traced to rv32i_cpu_top.v and pic.v; dimensions in bits."""
from diagrams import SVG, OUT, INK, ACC, MUT

def stage(d,x,w,title,h=950):
    d.s.append(f'<rect x="{x}" y="275" width="{w}" height="{h}" rx="6" fill="#F4F7F8" stroke="#CEDADD" stroke-width="2"/>')
    d.text(x+410 if title.startswith('S2') else x+w/2,327,title,35,bold=True)

def cpu():
    d=SVG(2400,1330)
    stage(d,40,470,'S1 · FETCH')
    stage(d,770,1100,'S2 · DECODE + EXECUTE')
    stage(d,2140,220,'S3 · WB',610)
    d.box(80,25,370,130,'Instruction memory',['AXI4-Lite · read only'])
    d.box(1450,25,420,130,'Data memory / peripherals',['AXI4-Lite · read + write'])
    d.box(80,470,370,220,'Fetch unit',['PC / instruction fetch','AXI handshake + redirect','outstanding-read tracking'])
    d.box(80,970,370,150,'Branch predictor',['1-bit BHT + tagged BTB','return-address stack'])
    d.box(800,470,450,220,'Decode + operands',['decode · immediate · control','32 × 32-bit GPRs; x0 = 0','two reads + S3 forwarding'])
    d.box(1480,470,350,220,'Execution',['ALU · branch · LSU','CSR result selection','load/store waits for R / B'])
    d.box(800,1040,1030,130,'CSR / traps / pipeline control',['CSR commit · exception / IRQ · redirect · stall / flush · predictor update'])
    d.box(2160,470,180,220,'WB mux',['ALU/CSR','load','PC + 4'])
    for x,label in [(620,'IF / DX'),(2010,'DX / WB')]:
        d.s.append(f'<rect x="{x}" y="470" width="20" height="220" fill="#D4E3E5" stroke="{ACC}" stroke-width="2"/>')
        d.text(x+10,800,label,25,bold=True)
    d.line([(135,470),(135,155)])
    d.line([(410,155),(410,470)])
    d.text(270,205,['AR address 32','R data 32'],27)
    d.line([(1530,470),(1530,155)])
    d.line([(1790,155),(1790,470)])
    d.text(1660,192,['AW / AR address 32','W / R data 32','B / R response 2'],23)
    d.line([(450,540),(800,540)])
    d.text(625,411,['instruction + PC','32 each'],28)
    d.text(625,729,['pred. target 32 · taken 1','fault / valid: 1 each'],23)
    d.line([(1250,540),(1480,540)])
    d.text(1365,411,['operands / immediate','32 each'],26)
    d.line([(1830,540),(2160,540)])
    d.text(1995,411,['ALU/CSR · load · PC+4','32 each'],26)
    d.text(2000,729,['rd 5 · select 2','write / valid: 1 each'],23)
    d.line([(185,690),(185,970)])
    d.text(165,862,['PC','32'],24,anchor='end')
    d.line([(350,970),(350,690)])
    d.text(377,862,['target 32','taken 1'],24,anchor='start')
    d.line([(2250,690),(2250,775),(1180,775),(1180,690)])
    d.text(1590,727,['WB data 32 · rd 5','write / forward'],25)
    d.line([(800,1135),(710,1135),(710,1180),(270,1180),(270,1120)])
    d.text(435,1209,'predictor update',23)
    d.text(520,1239,'PC / target / link: 32 each',23)
    d.line([(1010,690),(1010,1040)])
    d.text(1040,874,['decoded operation','CSR address 12 / data 32'],24,anchor='start')
    d.line([(1485,1040),(1485,690)])
    d.text(1510,864,['CSR value','32'],24,anchor='start')
    d.line([(1740,690),(1740,1040)])
    d.text(1765,868,['branch result','LSU busy / done / error'],23,anchor='start')
    d.line([(1125,1170),(1125,1280),(60,1280),(60,615),(80,615)])
    d.text(790,1265,'redirect · target PC 32',24)
    d.line([(800,1090),(755,1090),(755,650),(640,650)],dashed=True)
    d.text(775,852,['hold /','flush'],23,anchor='start')
    d.line([(1800,1170),(1800,1210),(1905,1210),(1905,955),(2110,955),(2110,650),(2030,650)],dashed=True)
    d.text(2085,840,['advance /','squash'],23,anchor='end')
    d.box(1930,990,430,200,'PIC (external)',['in: IRQ 1 · vector 4 · pending 16','out: mask 16','claim / EOI: 1 each'])
    d.line([(1930,1080),(1830,1080)])
    d.line([(1830,1115),(1930,1115)])
    d.text(1720,1304,'AXI4-Lite: VALID / READY 1 · PROT 3 · WSTRB 4.',24,color=MUT)
    d.save('cpu_essential')

def pic():
    d=SVG(2250,1310)
    d.box(50,280,510,220,'Source conditioning',['16 slots: HW level / edge OR software','enable mask · edge-pending latch','pending output excludes active sources'])
    d.box(850,280,570,220,'Priority / deadline / eligibility',['4 bands · intra-band priority · ID tie-break','16 timers × 16 bits; escalation policy','CPU mask + active / preemption filter'])
    d.box(1700,280,440,220,'Resolver + registered offer',['maximum eligible key','IRQ + source ID; saved claim ID'])
    d.box(50,840,510,200,'AXI4-Lite + register map',['32-bit address / data · WSTRB 4','configuration · keyed SW injection','per-source / global status'])
    d.box(1000,840,520,200,'Nesting / service context',['16-entry stack; reset limit 8','claim: push ID + key · EOI: pop','active mask · spurious detection'])
    d.box(1730,840,430,200,'CPU (external)',['mask / claim / EOI','IRQ / vector / pending'])
    d.text(195,100,['irq_src_i','16 synchronous inputs'],30)
    d.line([(200,160),(200,280)])
    d.text(760,110,['PIC functional groups: source → arbitration → service','AXI4-Lite front-end: axi_lite_slave'],26,anchor='start',color=MUT)
    d.line([(560,390),(850,390)])
    d.text(705,364,'requests · 16',29)
    d.line([(1420,390),(1700,390)])
    d.text(1560,334,['eligible 16','keys 16 × 10'],27)
    d.line([(1910,500),(1910,840)])
    d.text(1940,687,['IRQ 1','source ID 4'],27,anchor='start')
    d.line([(1800,840),(1800,650),(1380,650),(1380,500)])
    d.text(1690,594,['CPU mask','16'],27)
    d.line([(1200,840),(1200,500)])
    d.text(1100,584,['active 16','top key 10'],25)
    d.line([(1300,500),(1300,840)])
    d.text(1320,729,['source keys','16 × 10'],23,anchor='start')
    d.line([(1450,840),(1450,550),(1740,550),(1740,500)])
    d.text(1525,587,['depth < limit','1'],22)
    d.line([(1730,930),(1520,930)])
    d.text(1670,869,['claim 1','EOI 1'],25)
    d.line([(1700,440),(1600,440),(1600,1010),(1520,1010)])
    d.text(1625,784,'claim ID 4',24,anchor='start')
    d.line([(300,840),(300,500)])
    d.text(330,650,['enable 16','SW requests 16','trigger mode 16'],25,anchor='start')
    d.line([(120,500),(120,840)])
    d.text(145,615,['SRC status','PEND 16'],22,anchor='start')
    d.line([(480,840),(480,740),(1000,740),(1000,500)])
    d.text(860,632,['band: 4 × 2','intra: 16 × 4','deadline: 16 × 16'],22)
    d.line([(560,900),(1000,900)])
    d.text(815,881,'NEST_MAX · 5',23)
    d.line([(1000,980),(560,980)])
    d.text(855,963,'status / events',25)
    d.line([(850,450),(730,450),(730,980)])
    d.text(760,813,'deadline events',23,anchor='start')
    d.s.append(f'<circle cx="730" cy="980" r="6" fill="{ACC}"/>')
    d.line([(560,465),(650,465),(650,1140),(2020,1140),(2020,1040)])
    d.text(1810,1122,'pending mask · 16',27)
    d.line([(560,430),(680,430),(680,1100),(1110,1100),(1110,1040)])
    d.text(885,1084,'requests 16 · spurious check',22)
    d.line([(1200,1040),(1200,1210),(600,1210),(600,565),(500,565),(500,500)])
    d.text(915,1193,'active 16 · claimed ID 4 · clear 1',22)
    d.line([(130,1170),(130,1040)])
    d.line([(440,1040),(440,1170)])
    d.text(285,1227,['CPU register accesses','AW / W / AR requests; B / R responses'],24)
    d.text(1380,1280,'Priority key: urgency 2 + intra-band priority 4 + inverted ID 4.',26,color=MUT)
    d.save('pic_essential')

if __name__=='__main__':
    from diagrams import environment
    from software_diagrams import build as software
    cpu();pic();environment('cpu');environment('pic')
    software('cpu');software('pic')
    for kind in ('cpu','pic'):
        for suffix in ('svg','pdf','png'):
            (OUT/f'{kind}_architecture.{suffix}').write_bytes((OUT/f'{kind}_essential.{suffix}').read_bytes())
