C0SM1N23/siemens/(commit log)

2026-07-05 RV32I 3-stage pipeline CPU with dual AXI4-Lite masters
2026-07-10 add wfi + mtimer + ras + hpm counters, sva/fcov flow, fix arvalid in reset
    [branch_predictor.v, control.v, cpu_top.v, csr_file.v, fetch_unit.v, hazard_unit.v, mtimer.v]
2026-07-12 add reusable axi_lite_slave (pic+mtimer), shared filelists, tb axi wiring macros, named scoreboard slots, soc memory map
2026-07-20 move mtval into exception_unit's cause chain, forward BP_ENTRIES/RAS_DEPTH to branch_predictor, share tb check task + axi bare-read macros, make asm.py idempotent and verif_gui portable
2026-07-21 Add files via upload
    adaugat reset asincron date si adresa de scriere tacte diferite, registri + testbench + fisier txt cu teste
    [axi4lite_slave_fsm.v, collision_det.v, regfile.v]
2026-07-22 rework pic into a 16+16-source controller with priority bands, preemptive nesting, spurious detection, deadline escalation and keyed software triggers + full register map, rework the cpu irq interfac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
    [cpu_top.v, csr_file.v, exception_unit.v, pic.v]
2026-08-18 reset the if/dx instruction word to a nop so the decoder never drives x onto the axi valid lines
    [cpu_top.v]
2026-08-20 suffix every port with _i/_o, reset every remaining flop, and hardwire the pic reserved bits to zero
    [alu.v, alu_top.v, axi_lite_slave.v, branch_predictor.v, branch_unit.v, control.v, cpu_top.v, csr_file.v]
2026-08-20 pack the btb payload into vectors so the reset needs no loop verilator cannot unroll
    [branch_predictor.v]
2026-08-20 pin verilator --unroll-count 64 so a loop that breaks ci breaks the local build first
2026-08-22 add block benches for the branch predictor and the alu; grow the regression to 14 runs
    tb_bp covers the predictor state nothing else reaches: the reset values and
    X-freedom of the BTB arrays, the index space end to end, and the RAS overflow,
    underflow, both-link replace and RAS_DEPTH=0 cases. tb_alu covers the ALUOp
    decode exhaustively plus every shift amount and the operand boundaries.
    Also correct the register count tb_pic_reset prints: the PIC maps 56 words, of
    which 8 are global, not 59 and 11.
2026-08-22 add a verification roadmap for the work the current regression does not cover
    Backlog, not a record: conformance (riscv-arch-test, a reference model,
    randomised streams), cheap extensions to the existing benches (reset
    mid-transaction, parameter sweeps, nesting through the CPU, block benches for
    imm_gen and control), and what sits outside simulation (lint, synthesis,
    formal). Each item says what the gap is, why it matters and what closing it
    costs.
2026-08-22 correct the state diagrams and signal names against the rtl, and redraw them so nothing overlaps
    Accuracy: the escalated band, deadline counter and ESC flag revert at the claim,
    not at the end of interrupt; a redirect arms discard_q from AR_PEND as well as
    IN_FLIGHT; the slave's write commit has a one-cycle BOTH state because the got
    bits are registered; a nested synchronous trap keeps both CPU trap flags high.
    Quoted RTL and figure labels now carry the _i/_o suffixes the ports actually
    have.
    Layout: state names were wider than their circles and edge labels landed on each
    other, worst in the slave write handshake and the SRCx_STATUS life cycle. States
    are boxes that fit their names, arc pai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
2026-08-22 cut the internal engineering rationale out of the deliverable
    Removes the reset-architecture and sequential-control chapters, the
    compile-order rationale and the port-naming rationale. These document coding
    decisions, not delivered behaviour: how many always blocks drive a register,
    why every internal flop is reset and what that costs on the reset tree, which
    modules hold a state register versus flags. The reset values software can
    observe were never in those chapters alone - they are in each block's register
    map and in appendix A.
    What the reader still needs is kept and moved to where it belongs: the file
    list and build commands into the module inventory appendix, the CPU trap-flag
    diagram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
2026-08-23 move the dma block under dma/ for soc integration
2026-08-23 drive the dma irq from int_status masked by int_enable
2026-08-23 add the soc system test: cpu drives a dma transfer into the sram
2026-08-23 add the soc regression flow and wire it into the makefile
2026-08-23 rewrite the readme as the soc landing page
2026-08-23 add the sva layer for the interconnect and a verilator flow for the soc
2026-08-23 redraw the system diagram with boxed stages
2026-08-25 tighten the docs and correct the sram wstrb severity
2026-08-29 fix interrupt nesting, mask handling and the peripheral windows
    [cpu_top.v, csr_file.v, pic.v, soc_top.v]
2026-08-31 test dma transfer lengths that are not whole bursts
2026-09-07 prefix cpu and soc rtl with rv32i_ and soc_
    Avoids name collisions when the three blocks compile into one library, and
    puts one port connection per line in every instantiation.
    [mtimer.v, pic.v, rv32i_alu.v, rv32i_alu_top.v, rv32i_branch_predictor.v, rv32i_branch_unit.v, rv32i_control.v, rv32i_cpu_top.v]
2026-09-07 add ten soc benches and grow the regression to 24 runs
    Covers the areas the system test never reached: all sixteen interrupt sources,
    preemption and nesting through the core, deadline escalation, the four DMA
    channels under round-robin, a masked channel interrupt, a burst overrunning its
    window, the machine timer armed from software, peripheral backpressure, an
    error on a beat inside a burst, and the two address-map declarations against
    each other.
2026-09-07 assemble the new soc programs and ignore the moved diagram sources
2026-09-07 add the design and verification specifications under cpu/docs
    Two pairs, for the core and for the interrupt controller, following the
    department template. They sit next to the rtl they describe rather than in a
    central docs tree.
2026-09-14 Fixed token bucket edge case
    [mc_dma_channel.v]
2026-09-14 Relocate upstream dma sources for SoC integration
2026-09-14 Connect SoC and benches to the updated DMA and SRAM interfaces
2026-09-15 Simplify CPU RTL and fix counter semantics
    [axi_lite_slave.v, mtimer.v, pic.v, rv32i_alu.v, rv32i_alu_top.v, rv32i_branch_predictor.v, rv32i_branch_unit.v, rv32i_control.v]
2026-09-15 Fix SoC transaction routing and response handling
    [soc_axi_full2lite.v, soc_axi_lite_arb.v, soc_axi_lite_dec.v, soc_axi_lite_ram.v, soc_top.v]
2026-09-16 Fix Verilator CI builds and PIC escalation
    [axi_lite_slave.v, mc_dma_axi4_full_master.v, mc_dma_channel.v, mtimer.v, pic.v, soc_axi_full2lite.v, soc_axi_lite_arb.v, soc_axi_lite_dec.v]
2026-09-16 hold one transaction per channel in the soc fabric
    the decoder kept a single read route but accepted the next AR before the
    pending R was taken, so RDATA moved under RVALID and the response came from
    the wrong slave. track the accepted read like the writes already were, and
    refuse the next address on both sides until its response is taken.
    the same gate now qualifies the DECERR responder's own bookkeeping, which
    could otherwise record an acceptance the master port had refused.
    arbiter: one address and one data beat per grant, so a master that already
    has its next write ready cannot hand the slave two transactions under one
    grant. bridge: word alignment joins the accepted transfer profile -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
    [soc_axi_full2lite.v, soc_axi_lite_arb.v, soc_axi_lite_dec.v]
2026-09-16 cover the fabric ordering rules in the mutation suite
    three new cases: the decoder's read gate, the arbiter's per-grant address
    gate and the bridge's alignment check. the arbiter direction anchor moved
    when ar_taken_q was added, so it is retargeted at the current expression.
    16/16 detected, baselines pass.
2026-09-24 test interrupt and exception races in the trap bench
2026-09-24 check that the timer interrupt rises when mtime equals mtimecmp
2026-09-24 let nest_max drop below the current depth in the pic assertions
2026-09-24 expose memory latency and stall parameters on the soc benches
2026-09-24 add soc benches for cpu isolation, dma faults and reset under traffic
2026-09-24 add soc benches for a spurious claim and sixteen nested interrupts
2026-09-24 probe the dma control word, descriptor fetch and resume
2026-09-24 add mutations for the new cpu, pic, timer and fabric checks
2026-09-24 document the dma and sram findings with their impact
2026-09-24 build verilator 5.050 in ci to match the recorded flows
